lhr-solar/Power-SupplementalMonitoringPCB/Power-SupplementalMonitoringPCB.FCStd

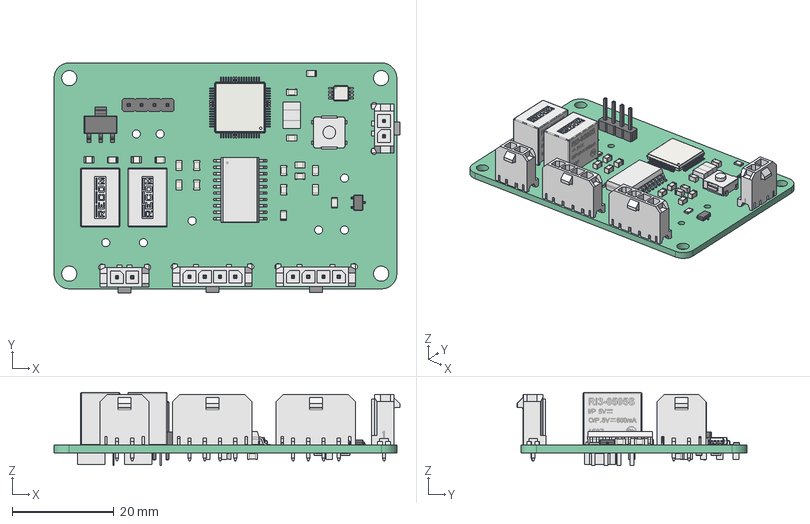
[picture p1: CAD file, 2021-01-23]
Power-SupplementalMonitoringPCB.FCStd
68.1 x 45.3 x 14.4 mm
Pcb_b4a3
R9_R_0805_2012Metric_5FDE7C33
SW1_B3SL_100[]P_5FCB5CA1[2]
U5_SOT_223_5FCB5DBF
U6_RI3_5FD559DC
R5_R_0805_2012Metric_5FD55737
D2_LED_0805_2012Metric_5FD566A9
U2_SOIC-20W_5FCB5D84[2]
U7_VSSOP_8_30x30mm_P065mm_5FCC9164
J1_PinHeader_1x04_P254mm_Vertical_5FCB5B7C
J3_436500428_5FCB5BBE
J2_436500428_5FCB5B9D
Y1_CRYSTAL_TXC_7A_TXC_5FCB9A00
U4_RI3_5FCB5DA9
U3_SOT_23W_5FCB5D99
U1_LQFP_64_10x10mm_P05mm_5FCB5D67
R3_R_0805_2012Metric_5FCB5C43
R2_R_0805_2012Metric_5FCB5C32
R1_R_0805_2012Metric_5FCB5C21
L2_L_0805_2012Metric_5FCB5C10
L1_L_0805_2012Metric_5FCB5BFF
J5_436500227_5FCBF2D8
J4_436500227_5FCBB549
D1_LED_0805_2012Metric_5FCB5B64
C19_C_0805_2012Metric_5FCB5B0F
C18_C_0805_2012Metric_5FCB5AFE
C17_C_0805_2012Metric_5FCB5AED
C16_C_0805_2012Metric_5FCB5ADC
C15_C_0805_2012Metric_5FCB5ACB
C14_C_0805_2012Metric_5FCB5ABA
C13_C_0805_2012Metric_5FCB5AA9
C12_C_0805_2012Metric_5FCB5A98
C2_C_0805_2012Metric_5FCB59EE
C1_C_0805_2012Metric_5FCB59DD
R8_R_0805_2012Metric_5FDE7C22
R6_R_0805_2012Metric_5FDD9597
C23_c_2220_5750metric_5FD56078
R7_R_0805_2012Metric_5FCBD85C
R4_R_0805_2012Metric_5FCBD928
C22_C_0805_2012Metric_5FCB5B51
C21_C_0805_2012Metric_5FD563E3
C20_c_2220_5750metric_5FCC2A87
C11_C_0805_2012Metric_5FCB5A87
C10_C_0805_2012Metric_5FCB5A76
C9_C_0805_2012Metric_5FCB5A65
C8_C_0805_2012Metric_5FCB5A54
C7_C_0805_2012Metric_5FCB5A43
C6_C_0805_2012Metric_5FCB5A32
C5_C_0805_2012Metric_5FCB5A21
C4_C_0805_2012Metric_5FCB5A10
C3_C_0805_2012Metric_5FCB59FF
