lhr-solar/Power-SupplementalMonitoringPCB/(list of files, cad)

Other CAD files:
Power-SupplementalMonitoringPCB.stl
