lhr-solar/Power-SupplementalMonitoringPCB/Power-SupplementalMonitoringPCBDimensions.pdf

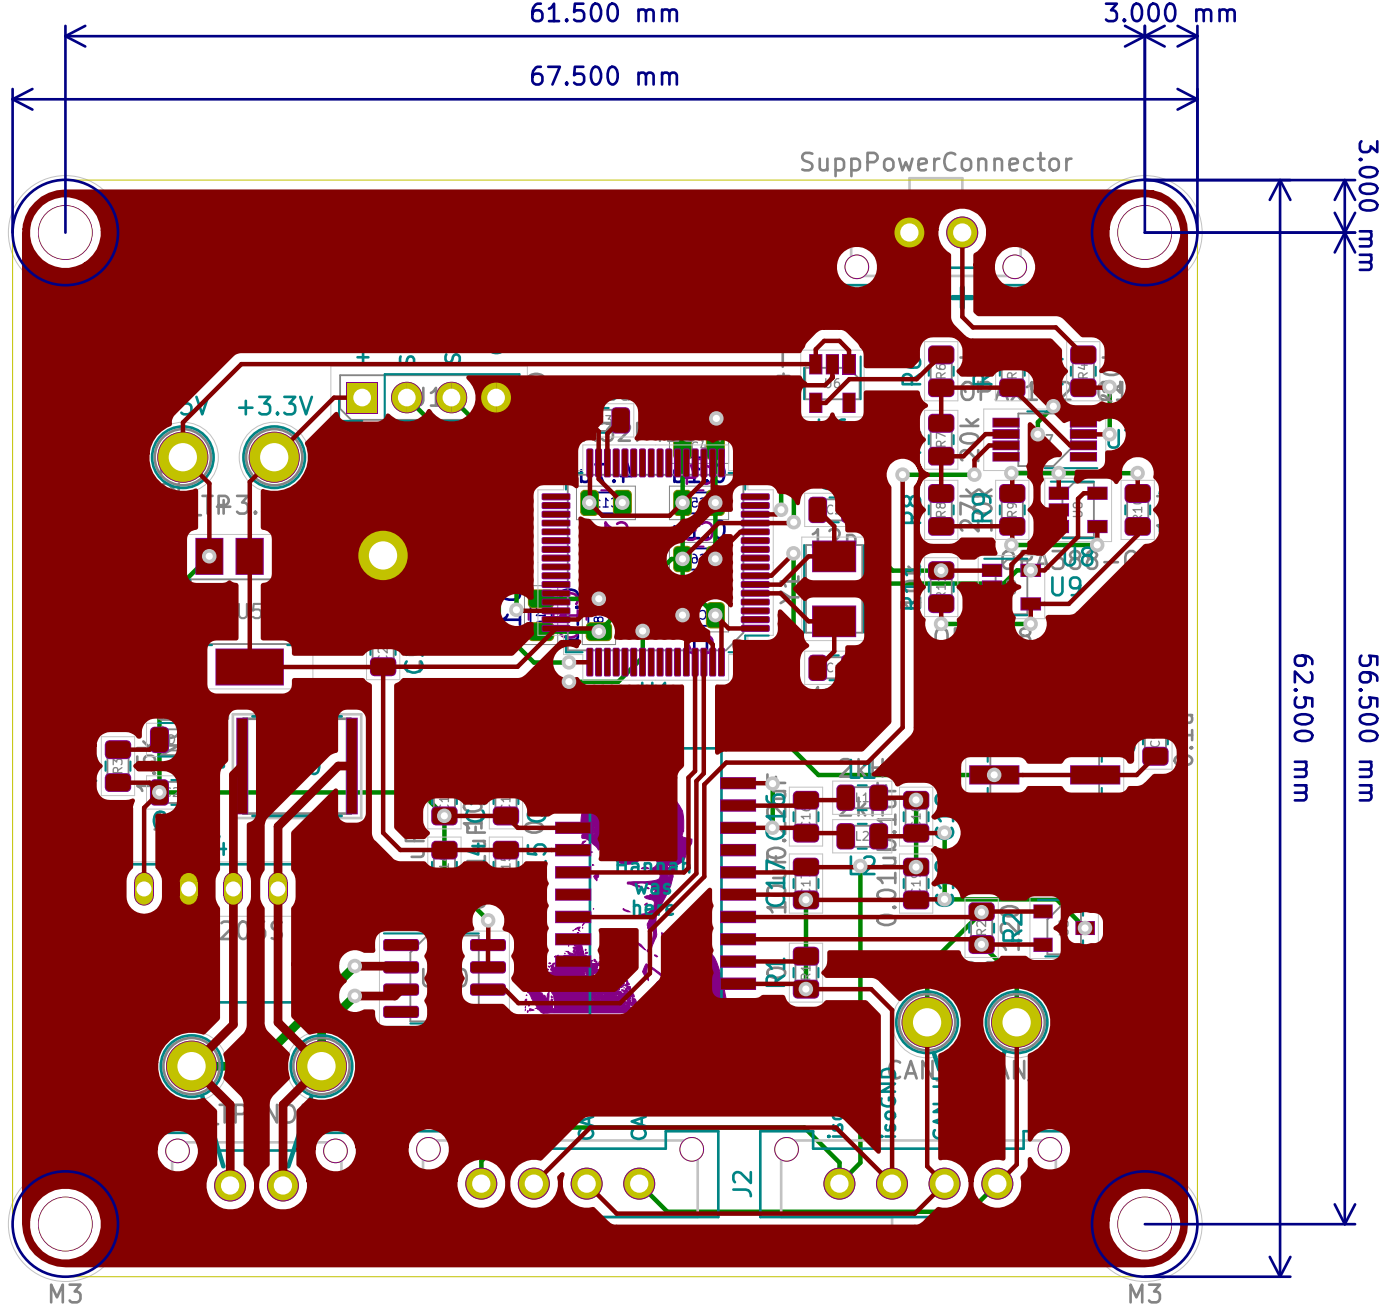
[picture p2: page 1]
