lhr-solar/Power-SupplementalMonitoringPCB/Power-SupplementalMonitoringPCB.kicad_pcb

## KiCad design Power-SupplementalMonitoringPCB.kicad_pcb (2023-09-02)

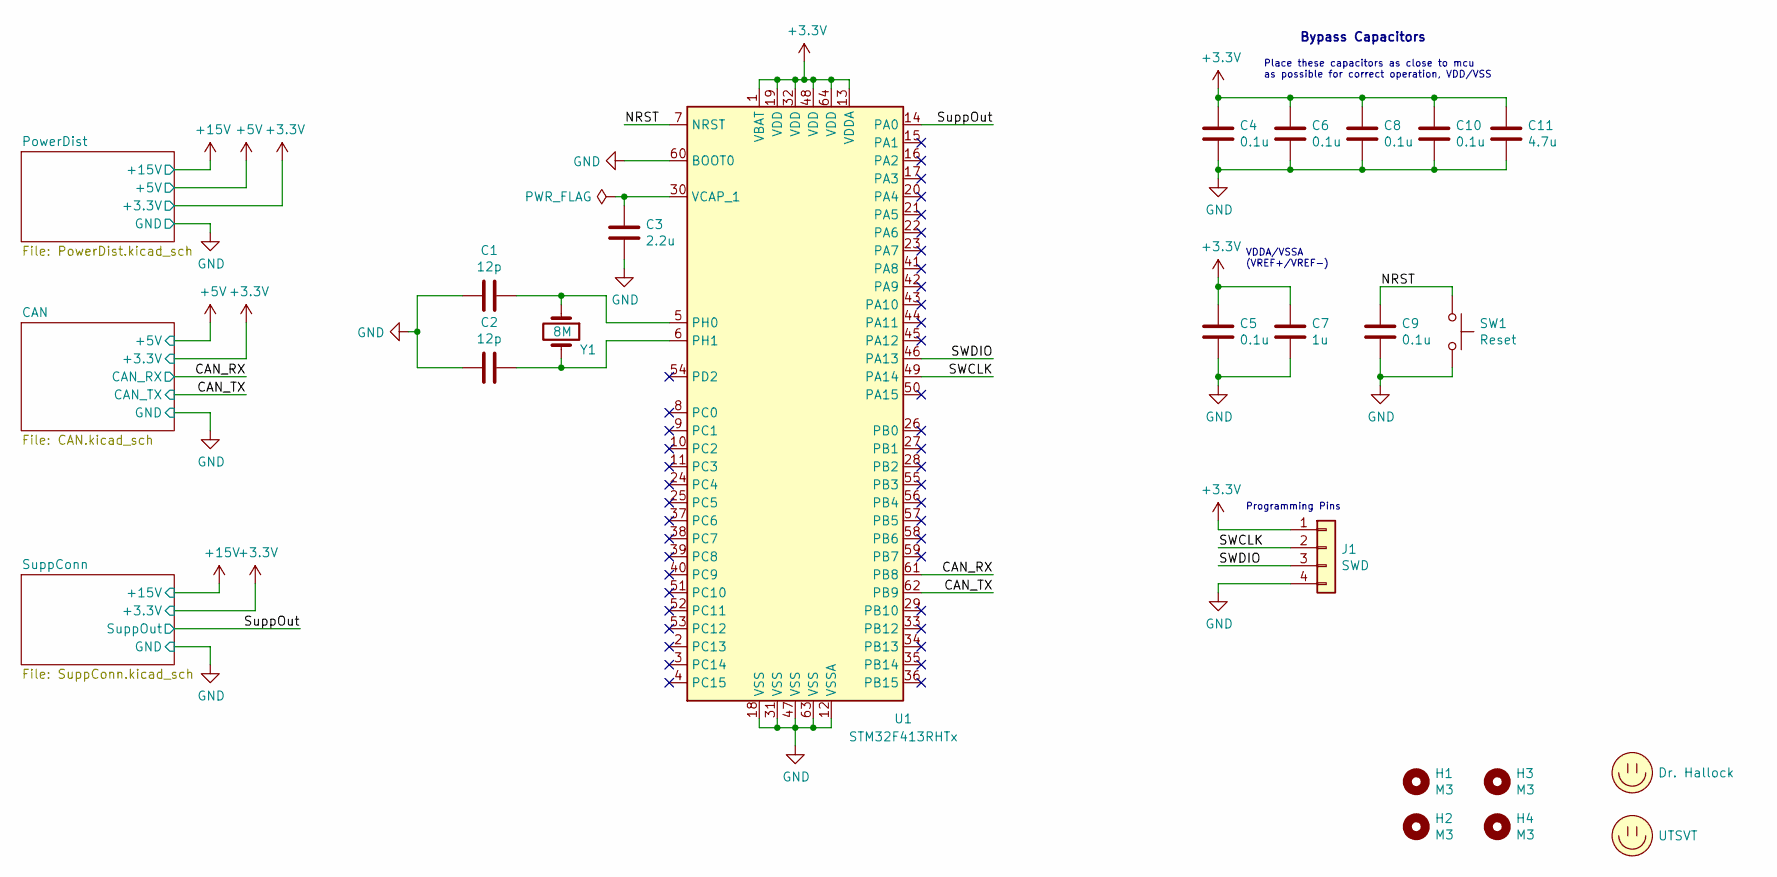
[picture p3: schematic Power-SupplementalMonitoringPCB.kicad_sch]

Parts:
C1, C2: 12p; C_0805_2012Metric
C3: 2.2u; C_0805_2012Metric
C4, C5, C6, C8, C9, C10: 0.1u; C_0805_2012Metric
C7: 1u; C_0805_2012Metric
C11: 4.7u; C_0805_2012Metric
H1, H2, H3, H4: M3; MountingHole_3mm
J1: SWD; PinHeader_1x04_P2.54mm_Vertical
LOGO1: Dr. Hallock; Hallock_Image_Tiny
LOGO2: UTSVT; UTSVT_Logo_Symbol
SW1: Reset; SW_SPST_B3SL-1002P
U1: STM32F413RHTx; LQFP-64_10x10mm_P0.5mm
Y1: 8M; Crystal_SMD_TXC_7A-2Pin_5x3.2mm

Connections:
+3V3: C4.1, C5.1, C6.1, C7.1, C8.1, C10.1, C11.1, J1.1, U1.1 (VBAT), U1.13 (VDDA), U1.19 (VDD), U1.32 (VDD), U1.48 (VDD), U1.64 (VDD); also elsewhere on the board
/CAN_RX: U1.61 (PB8); also elsewhere on the board
/CAN_TX: U1.62 (PB9); also elsewhere on the board
/NRST: C9.1, SW1.1, U1.7 (NRST)
/SWCLK: J1.2, U1.49 (PA14)
/SWDIO: J1.3, U1.46 (PA13)
/SuppOut: U1.14 (PA0); also elsewhere on the board
GND: C1.2, C2.2, C3.2, C4.2, C5.2, C6.2, C7.2, C8.2, C9.2, C10.2, C11.2, J1.4, SW1.2, U1.12 (VSSA), U1.18 (VSS), U1.31 (VSS), U1.47 (VSS), U1.60 (BOOT0), U1.63 (VSS); also elsewhere on the board
unnamed: C1.1, U1.5 (PH0), Y1.1
unnamed: C2.1, U1.6 (PH1), Y1.2
unnamed: C3.1, U1.30 (VCAP_1)

Notes on the sheet:
Programming Pins
Place these capacitors as close to mcu as possible for correct operation, VDD/VSS
Bypass Capacitors
VDDA/VSSA (VREF+/VREF-)

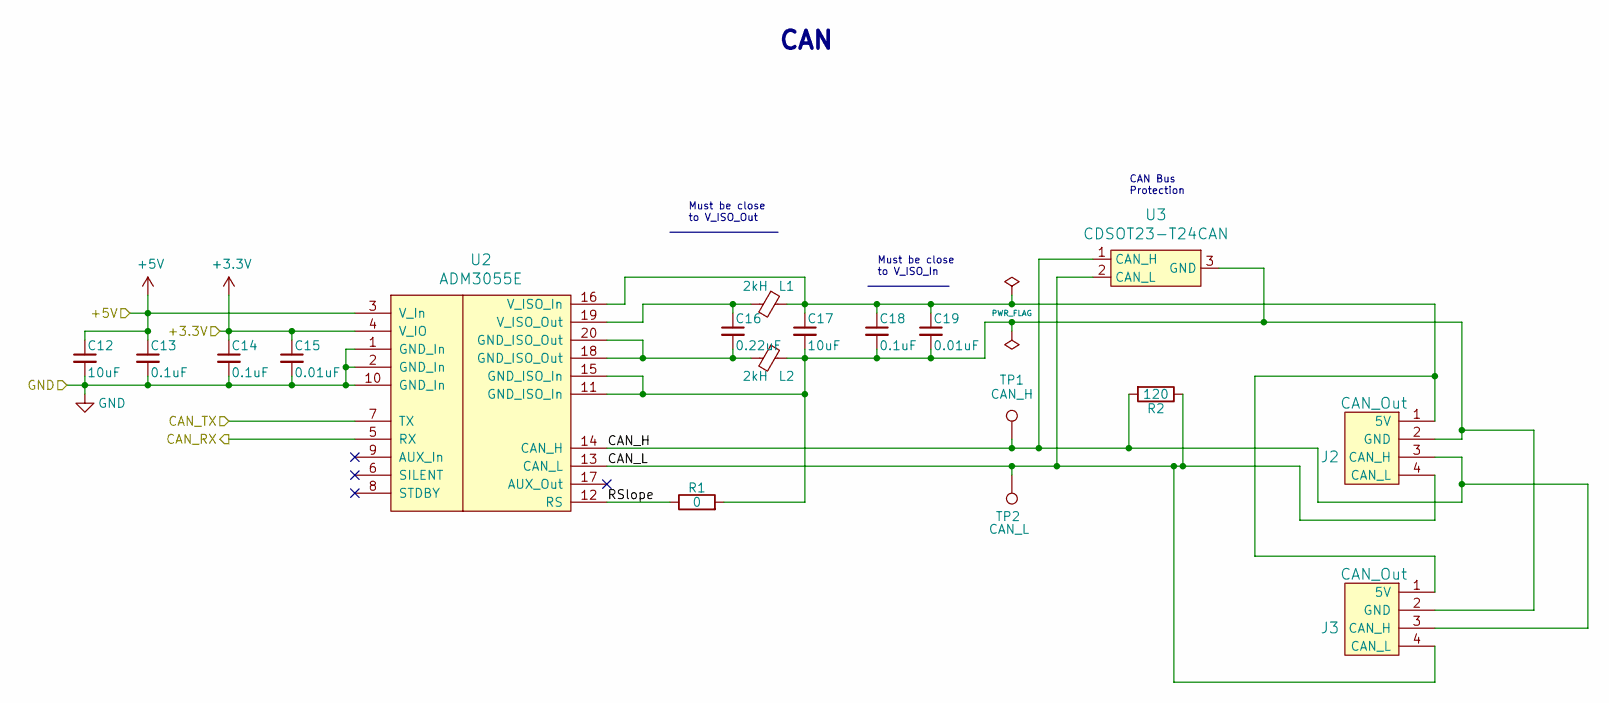
[picture p4: schematic CAN.kicad_sch]

Parts:
C12, C17: 10uF; C_0805_2012Metric
C13, C14, C18: 0.1uF; C_0805_2012Metric
C15, C19: 0.01uF; C_0805_2012Metric
C16: 0.22uF; C_0805_2012Metric
J2, J3: CAN_Out; Molex_MicroFit3.0_1x4xP3.00mm_PolarizingPeg_Vertical
L1, L2: 2kH; L_0805_2012Metric
R1: 0; R_0805_2012Metric
R2: 120; R_0805_2012Metric
TP1: CAN_H; TestPoint_Keystone_5005-5009_Compact
TP2: CAN_L; TestPoint_Keystone_5005-5009_Compact
U2: ADM3055E; SOIC-20W_7.5x15.4mm_Pitch1.27mm
U3: CDSOT23-T24CAN; SOT-23W

Connections:
+3V3: C14.1, C15.1, U2.4 (V_IO); also elsewhere on the board
+5V: C12.1, C13.1, U2.3 (V_In); also elsewhere on the board
/CAN/CAN_H: J2.3 (CAN_H), J3.3 (CAN_H), R2.2, TP1.1, U2.14 (CAN_H), U3.1 (CAN_H)
/CAN/CAN_L: J2.4 (CAN_L), J3.4 (CAN_L), R2.1, TP2.1, U2.13 (CAN_L), U3.2 (CAN_L)
/CAN/RSlope: R1.1, U2.12 (RS)
/CAN_RX: U2.5 (RX); also elsewhere on the board
/CAN_TX: U2.7 (TX); also elsewhere on the board
GND: C12.2, C13.2, C14.2, C15.2, U2.1 (GND_In), U2.2 (GND_In), U2.10 (GND_In); also elsewhere on the board
unnamed: C16.1, L1.2, U2.19 (V_ISO_Out)
unnamed: C16.2, L2.2, U2.18 (GND_ISO_Out), U2.20 (GND_ISO_Out)
unnamed: C17.1, C18.1, C19.1, J2.1 (5V), J3.1 (5V), L1.1, U2.16 (V_ISO_In)
unnamed: C17.2, C18.2, C19.2, J2.2 (GND), J3.2 (GND), L2.1, R1.2, U2.11 (GND_ISO_In), U2.15 (GND_ISO_In), U3.3 (GND)

Notes on the sheet:
Must be close to V_ISO_In
Must be close to V_ISO_Out
CAN Bus Protection
CAN

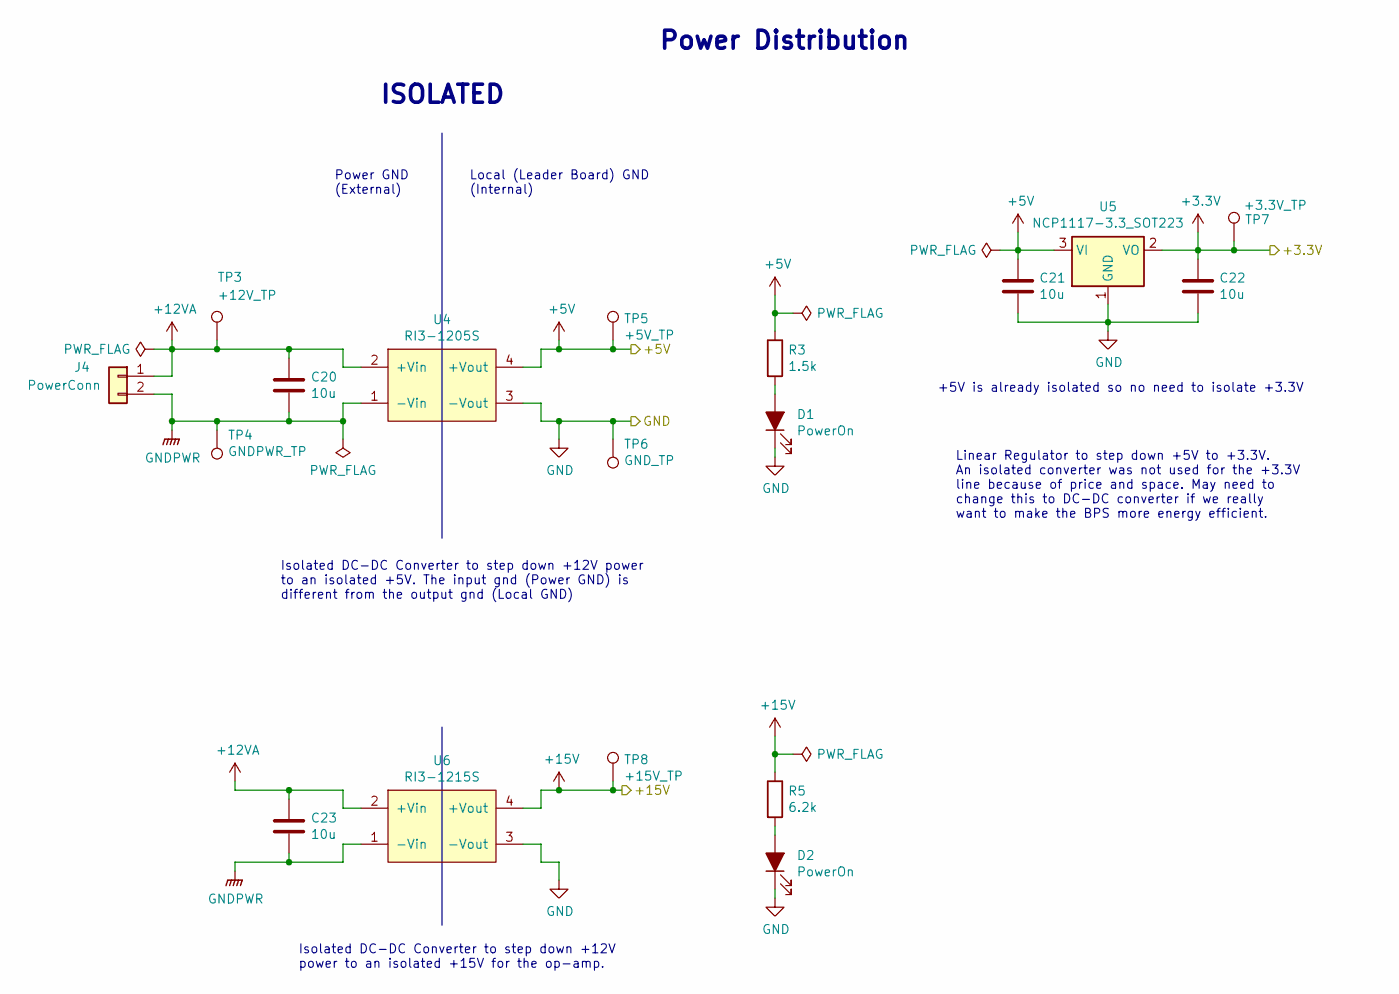
[picture p5: schematic PowerDist.kicad_sch]

Parts:
C20, C23: 10u; C_2220_5750Metric
C21, C22: 10u; C_0805_2012Metric
D1, D2: PowerOn; LED_0805_2012Metric
J4: PowerConn; Molex_MicroFit3.0_1x2xP3.00mm_PolarizingPeg_Vertical
R3: 1.5k; R_0805_2012Metric
R5: 6.2k; R_0805_2012Metric
TP3: +12V_TP; TestPoint_Keystone_5005-5009_Compact
TP4: GNDPWR_TP; TestPoint_Keystone_5005-5009_Compact
TP5: +5V_TP; TestPoint_Keystone_5005-5009_Compact
TP6: GND_TP; TestPoint_Keystone_5005-5009_Compact
TP7: +3.3V_TP; TestPoint_Keystone_5005-5009_Compact
TP8: +15V_TP; TestPoint_Keystone_5005-5009_Compact
U4: RI3-1205S; RI3_DC_Converter
U5: NCP1117-3.3_SOT223; SOT-223-3_TabPin2
U6: RI3-1215S; RI3_DC_Converter

Connections:
+3V3: C22.1, TP7.1, U5.2 (VO); also elsewhere on the board
+5V: C21.1, R3.1, TP5.1, U4.4 (+Vout), U5.3 (VI); also elsewhere on the board
+12VA: C20.1, C23.1, J4.1, TP3.1, U4.2 (+Vin), U6.2 (+Vin)
+15V: R5.1, TP8.1, U6.4 (+Vout); also elsewhere on the board
GND: C21.2, C22.2, D1.1 (K), D2.1 (K), TP6.1, U4.3 (-Vout), U5.1 (GND), U6.3 (-Vout); also elsewhere on the board
GNDPWR: C20.2, C23.2, J4.2, TP4.1, U4.1 (-Vin), U6.1 (-Vin)
unnamed: D1.2 (A), R3.2
unnamed: D2.2 (A), R5.2

Notes on the sheet:
Power GND (External)
Isolated DC-DC Converter to step down +12V power to an isolated +5V. The input gnd (Power GND) is different from the output gnd (Local GND)
ISOLATED
+5V is already isolated so no need to isolate +3.3V
Local (Leader Board) GND (Internal)
Power Distribution
Isolated DC-DC Converter to step down +12V power to an isolated +15V for the op-amp.
Linear Regulator to step down +5V to +3.3V. An isolated converter was not used for the +3.3V line because of price and space. May need to change this to DC-DC converter if we really want to make the BPS more energy efficient.

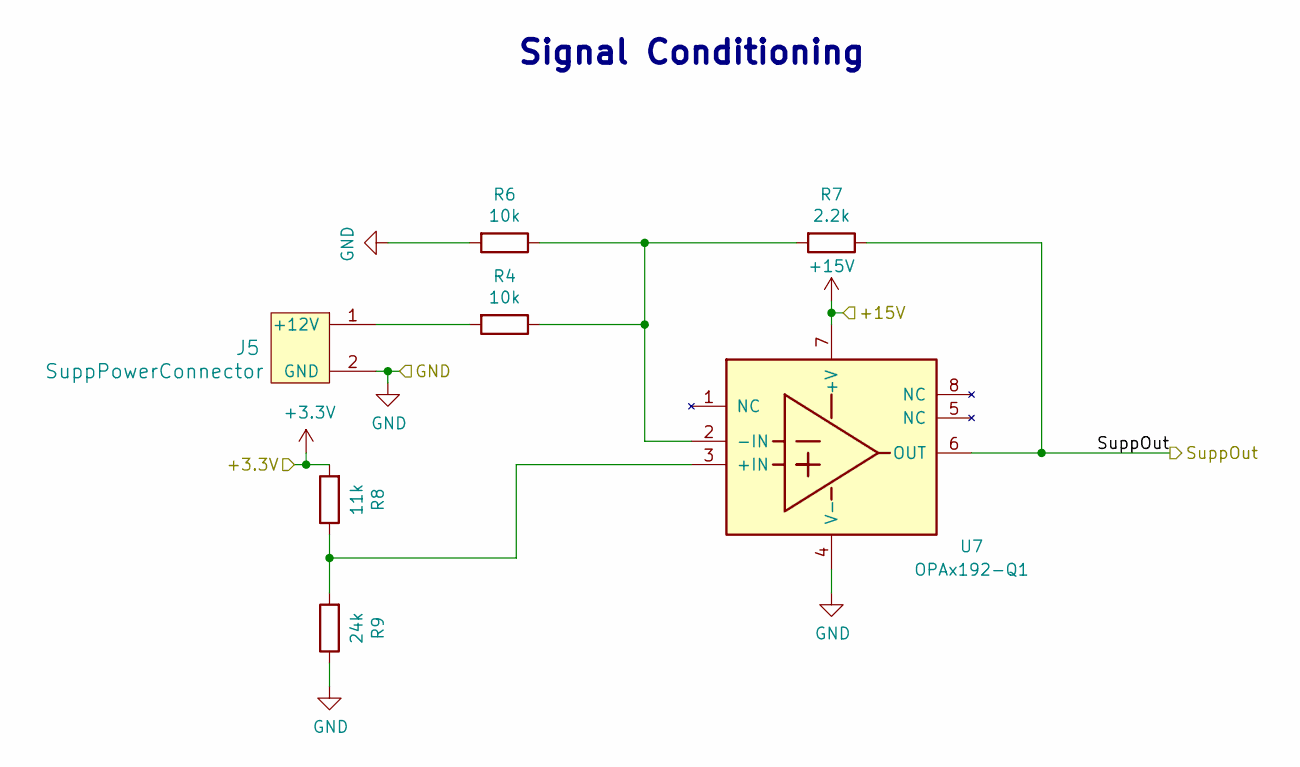
[picture p6: schematic SuppConn.kicad_sch]

Parts:
J5: SuppPowerConnector; Molex_MicroFit3.0_1x2xP3.00mm_PolarizingPeg_Vertical
R4, R6: 10k; R_0805_2012Metric
R7: 2.2k; R_0805_2012Metric
R8: 11k; R_0805_2012Metric
R9: 24k; R_0805_2012Metric
U7: OPAx192-Q1; VSSOP-8_3.0x3.0mm_P0.65mm

Connections:
+3V3: R8.2; also elsewhere on the board
+15V: U7.7 (+V); also elsewhere on the board
/SuppOut: R7.1, U7.6 (OUT); also elsewhere on the board
GND: J5.2 (GND), R6.2, R9.1, U7.4 (V-); also elsewhere on the board
unnamed: J5.1 (+12V), R4.2
unnamed: R4.1, R6.1, R7.2, U7.2 (-IN)
unnamed: R8.1, R9.2, U7.3 (+IN)

Notes on the sheet:
Signal Conditioning

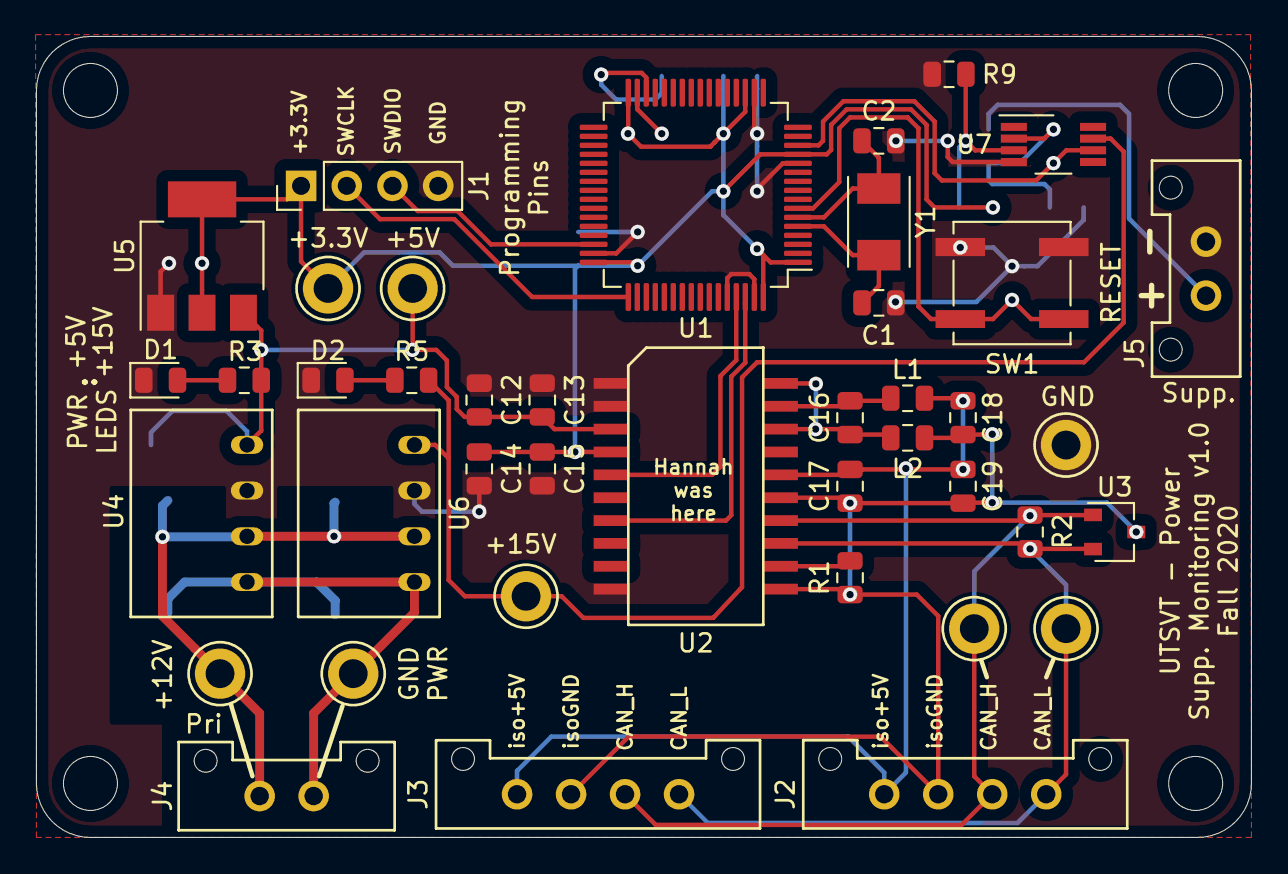
[picture p7: board Power-SupplementalMonitoringPCB.kicad_pcb from above]

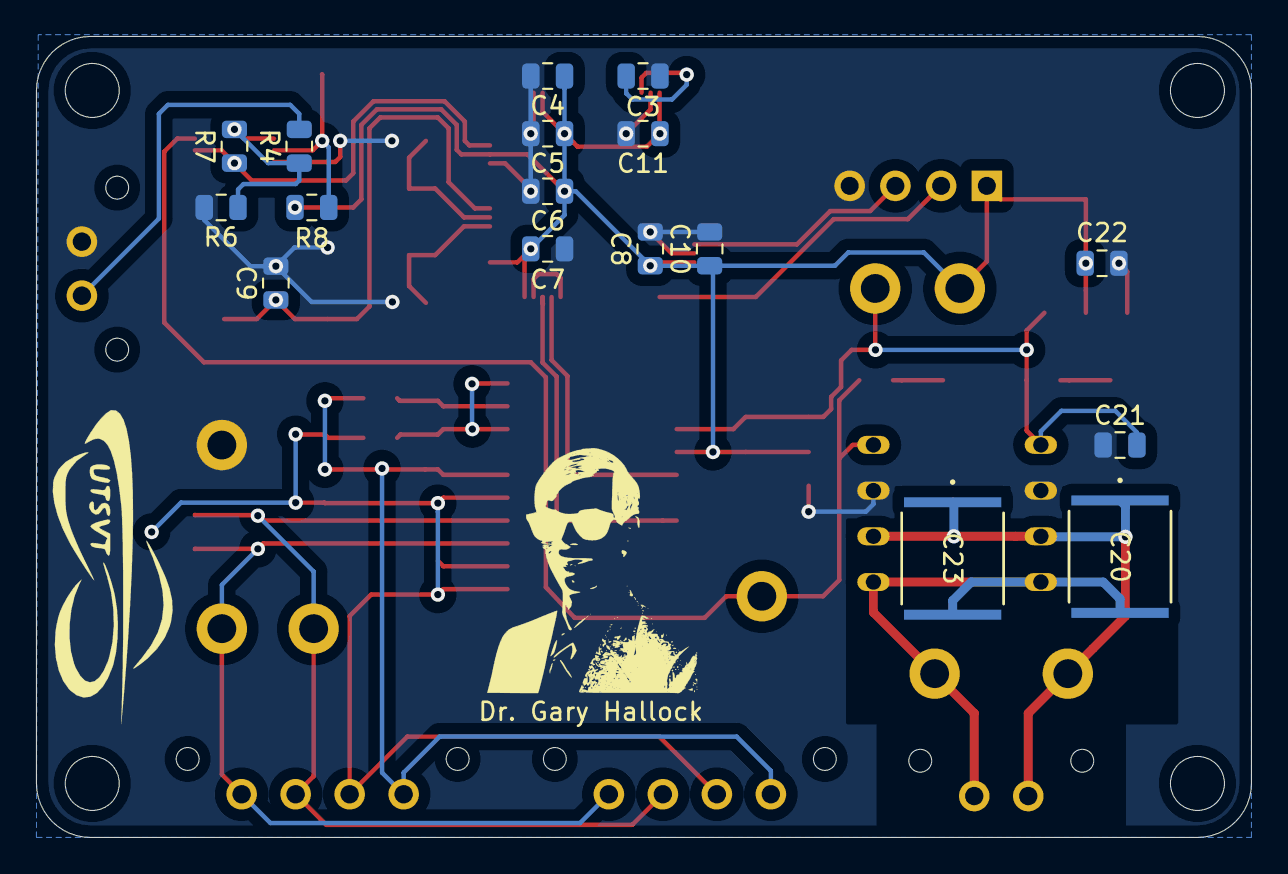
[picture p8: board Power-SupplementalMonitoringPCB.kicad_pcb from below]

Board: 2 copper layers, 67.5 x 44.5 mm, 64 parts (19 on the bottom side), 27 nets.
