lhr-solar/Power-SupplementalMonitoringPCB/(threads)

Thread 2 (2021-12-17):

No overvoltage protection for ADC

ClarkPoon, 2021-12-17:
The op-amp circuitry on this board can go from 0V to 15V, since those are the op-amp's positive and negative rails. I think it would be a good idea to have some overvoltage protection on future revisions of this board, so we don't accidentally damage the STM32F413 if we mess up the analog circuitry or give an unexpected input to the board.
