lhr-solar/Power-SupplementalMonitoringPCB/(commit log)

2020-11-21 Adds hierarchical sheets, picks PC0 for ADC
    Adds CAN & power distribution sheets. The VoltageDivision sheet is probably not needed (it uses the TPS3711 IC as a voltage comparator). PC0 is picked to be the ADC input (but we probably won't use the voltage divider as it is on the schematic right now, an op amp will replace the voltage divider).
    [CAN.sch, PowerDist.sch, VoltageDivision.sch, secondarypower.sch]
2020-11-30 Adds programming pins, bypass capacitors, & op amp
    VoltageDivision.sch now uses OPA2990 to attenuate the supplemental battery signal by ~4. Timing crystal, NRST, bypass capacitors, & SWDIO & SWCLK connections added in.
    [VoltageDivision.sch, secondarypower.sch]
2020-11-30 Added power flags
    [VoltageDivision.sch]
2020-12-05 Lays out schematic and PCB of v1.0
    [CAN.sch, Power-SupplementalMonitoringPCB.kicad_pcb, Power-SupplementalMonitoringPCB.sch, PowerDist.sch, SuppConn.sch, VoltageDivision.sch, secondarypower.sch]
2020-12-18 Makes edits from critical design review
    [Power-SupplementalMonitoringPCB.kicad_pcb, Power-SupplementalMonitoringPCB.sch, PowerDist.sch, SuppConn.sch]
2020-12-18 Fixes issue with the submodule
    [SuppConn.sch]
2020-12-19 Edits opamp circuitry to just one opamp and adds keepout zone under 12V and GNDPWR
    [Power-SupplementalMonitoringPCB.kicad_pcb, Power-SupplementalMonitoringPCB.sch, PowerDist.sch, SuppConn.sch]
2020-12-19 Correct op amp voltage measurement circuitry
    [CAN.sch, PowerDist.sch, SuppConn.sch]
2020-12-19 Fixes opamp circuitry
    [Power-SupplementalMonitoringPCB.kicad_pcb, PowerDist.sch, SuppConn.sch]
2021-01-10 Adds gerbers
    [Power-SupplementalMonitoringPCB-B_Cu.gbr, Power-SupplementalMonitoringPCB-B_Mask.gbr, Power-SupplementalMonitoringPCB-B_Paste.gbr, Power-SupplementalMonitoringPCB-B_SilkS.gbr, Power-SupplementalMonitoringPCB-Edge_Cuts.gbr, Power-SupplementalMonitoringPCB-F_Cu.gbr, Power-SupplementalMonitoringPCB-F_Mask.gbr, Power-SupplementalMonitoringPCB-F_Paste.gbr]
2021-01-23 ads 3D models
    [Power-SupplementalMonitoringPCB.FCStd, Power-SupplementalMonitoringPCB.kicad_pcb, Power-SupplementalMonitoringPCB.stl]
2023-09-02 added UTSVT-KiCADLibraries as a submodule, updated PCB and main schematic to KiCAD 7.0
